Alipay1/HPM6P41_BB/README.md

# HPM6P41四开关电源开发板

目前项目处于暂停状态，作者正在考研，非常抱歉！
您可以拉取项目的Rev3最终版本提交，这个版本可以通过测试用例，能够基本满足开发板的运行要求（ADC部分有噪声）
Rev4将在项目恢复更新后继续完善

# 测试用例

测试用例尚未完全整理，但已经可以运行

需要使用sdk_gui工具选择board与app生成您的测试用例SES工程
