Alipay1/HPM6P41_BB/SoftwareExamples/core_voltage/at24cxx/interface/driver_at24cxx_interface_template.c

/**
 * Copyright (c) 2015 - present LibDriver All rights reserved
 *
 * The MIT License (MIT)
 *
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
 * @file      driver_at24cxx_interface_template.c
 * @brief     driver at24cxx interface template source file
 * @version   2.0.0
 * @author    Shifeng Li
 * @date      2021-02-17
 *
 * <h3>history</h3>
 * <table>
 * <tr><th>Date        <th>Version  <th>Author      <th>Description
 * <tr><td>2021/02/17  <td>2.0      <td>Shifeng Li  <td>format the code
 * <tr><td>2020/10/15  <td>1.0      <td>Shifeng Li  <td>first upload
 * </table>
 */

#include "driver_at24cxx_interface.h"

#include "SEGGER_RTT.h"
#include <stdarg.h>

#include "board.h"
#include "board_i2c.h"

#include "hpm_i2c.h"

/**
 * @brief  interface iic bus init
 * @return status code
 *         - 0 success
 *         - 1 iic init failed
 * @note   none
 */
uint8_t at24cxx_interface_iic_init(void) {
    return 0;
}

/**
 * @brief  interface iic bus deinit
 * @return status code
 *         - 0 success
 *         - 1 iic deinit failed
 * @note   none
 */
uint8_t at24cxx_interface_iic_deinit(void) {
  return 0;
}

/**
 * @brief      interface iic bus read
 * @param[in]  addr iic device write address
 * @param[in]  reg iic register address
 * @param[out] *buf pointer to a data buffer
 * @param[in]  len length of the data buffer
 * @return     status code
 *             - 0 success
 *             - 1 read failed
 * @note       none
 */
uint8_t at24cxx_interface_iic_read(uint8_t addr, uint8_t reg, uint8_t *buf, uint16_t len) {
  return hpm_i2c_master_addr_read_blocking(board_get_i2c_context(), addr>>1, reg, 1, buf, len, 0xFF);
}

/**
 * @brief     interface iic bus write
 * @param[in] addr iic device write address
 * @param[in] reg iic register address
 * @param[in] *buf pointer to a data buffer
 * @param[in] len length of the data buffer
 * @return    status code
 *            - 0 success
 *            - 1 write failed
 * @note      none
 */
uint8_t at24cxx_interface_iic_write(uint8_t addr, uint8_t reg, uint8_t *buf, uint16_t len) {
  return hpm_i2c_master_addr_write_blocking(board_get_i2c_context(), addr>>1, reg, 1, buf, len, 0xFFFF);
}

/**
 * @brief      interface iic bus read with 16 bits register address
 * @param[in]  addr iic device write address
 * @param[in]  reg iic register address
 * @param[out] *buf pointer to a data buffer
 * @param[in]  len length of the data buffer
 * @return     status code
 *             - 0 success
 *             - 1 read failed
 * @note       none
 */
uint8_t at24cxx_interface_iic_read_address16(uint8_t addr, uint16_t reg, uint8_t *buf, uint16_t len) {
  return hpm_i2c_master_addr_read_blocking(board_get_i2c_context(), addr>>1, reg, 2, buf, len, 0xFF);
}

/**
 * @brief     interface iic bus write with 16 bits register address
 * @param[in] addr iic device write address
 * @param[in] reg iic register address
 * @param[in] *buf pointer to a data buffer
 * @param[in] len length of the data buffer
 * @return    status code
 *            - 0 success
 *            - 1 write failed
 * @note      none
 */
uint8_t at24cxx_interface_iic_write_address16(uint8_t addr, uint16_t reg, uint8_t *buf, uint16_t len) {
  return hpm_i2c_master_addr_write_blocking(board_get_i2c_context(), addr>>1, reg, 2, buf, len, 0xFF);
}

/**
 * @brief     interface delay ms
 * @param[in] ms time
 * @note      none
 */
void at24cxx_interface_delay_ms(uint32_t ms) {
  board_delay_ms(ms);
}

/**
 * @brief     interface print format data
 * @param[in] fmt format data
 * @note      none
 */

// void at24cxx_interface_debug_print(const char *const fmt, ...) {
//   char buf[128];
//   va_list args;
//   va_start(args, fmt);
//   int len = vsnprintf(buf, sizeof(buf), fmt, args);
//   va_end(args);
// }
