Alipay1/HPM6P41_BB/(commit log)

2025-05-19 首次提交，第一次打样的版本
    [BB.kicad_sch, HPM6P41_BB.kicad_pcb, HPM6P41_BB.kicad_sch, MCU_IO_A.kicad_sch, MCU_IO_B_C.kicad_sch, MCU_IO_D.kicad_sch, MCU_MISC.kicad_sch, MCU_MISC2.kicad_sch]
2025-05-19 添加README
2025-05-22 修复VDD_SOC的SNS未连接的错误
    [HPM6P41_BB.kicad_pcb, MCU_PWR.kicad_sch]
2025-05-22 更改所有封装为SOD-323的1N4148W为1N4148WS 添加分压器的钳位二极管
    [BB.kicad_sch, HPM6P41_BB.kicad_pcb, SENSE.kicad_sch]
2025-05-22 放置钳位二极管 修复分压器未接地
    [HPM6P41_BB.kicad_pcb]
2025-05-22 交换LED与按键位置，优化布线，调整位号丝印
    [HPM6P41_BB.kicad_pcb]
2025-05-22 添加JTAG接口的ESD保护
    [HPM6P41_BB.kicad_pcb, MCU_IO_A.kicad_sch, MCU_MISC.kicad_sch]
2025-05-22 添加蜂鸣器IO及走线，更改PINMUX配图
    [HPM6P41_BB.kicad_pcb, HPM6P41_BB.kicad_sch, MCU_MISC2.kicad_sch]
2025-05-22 修改丝印大小，位置
    [HPM6P41_BB.kicad_pcb, HPM6P41_BB.kicad_sch]
2025-05-23 Create main.yml
    AI生成的，我也不懂了
2025-05-23 删除main.yml，没用了
2025-05-23 放进Hardware目录
    [BB.kicad_sch, HPM6P41_BB.kicad_pcb, HPM6P41_BB.kicad_sch, MCU_IO_A.kicad_sch, MCU_IO_B_C.kicad_sch, MCU_IO_D.kicad_sch, MCU_MISC.kicad_sch, MCU_MISC2.kicad_sch]
2025-05-23 尝试修复上传为空的问题
2025-05-23 添加actions文件
2025-06-14 修改了UCC27211A封装，此芯片此前的封装均错误 修改了采样线布局，为SAR ADC加入前置RC
    [BB.kicad_sch, HPM6P41_BB.kicad_pcb, HPM6P41_BB.kicad_sch, MCU_MISC2.kicad_sch, MCU_PWR.kicad_sch, POWER.kicad_sch, SENSE.kicad_sch]
2025-06-14 换掉UCC27519，它居然要55%VDD才到逻辑高，换成UCC2751
    [BB.kicad_sch, HPM6P41_BB.kicad_pcb, HPM6P41_BB.kicad_sch, POWER.kicad_sch]
2025-06-18 Rev3最终版本
    [BB.kicad_sch, MCU_MISC.kicad_sch, SENSE.kicad_sch]
2025-06-18 修改PCB文件发布日期和REV信息
2025-07-03 外置核心电压SYR838以改善ADC噪声
    [HPM6P41_BB.kicad_sch, MCU_MISC.kicad_sch, MCU_MISC2.kicad_sch, MCU_PWR.kicad_sch, POWER.kicad_sch]
2025-07-04 换其他电感之前暂存一下
    [BB.kicad_sch, HPM6P41_BB.kicad_sch, MCU_IO_A.kicad_sch, MCU_MISC.kicad_sch, MCU_MISC2.kicad_sch, POWER.kicad_sch, SENSE.kicad_sch]
2025-07-10 完成Rev4 电源 驱动 模拟 IO
    [BB.kicad_sch, HPM6P41_BB.kicad_pcb, HPM6P41_BB.kicad_sch, MCU_IO_A.kicad_sch, MCU_MISC.kicad_sch, MCU_MISC2.kicad_sch, POWER.kicad_sch, SENSE.kicad_sch]
2025-08-18 更新readme暂停通知，添加测试用例源代码
    [HPM6P41_BB.kicad_pcb, MCU_MISC.kicad_sch, MCU_MISC2.kicad_sch]
2026-01-24 rev4修改核心供电前保存（当前SYR838）
    [BB.kicad_sch, HPM6P41_BB.kicad_pcb, HPM6P41_BB.kicad_sch, MCU_IO_A.kicad_sch, MCU_IO_B_C.kicad_sch, MCU_IO_D.kicad_sch, MCU_MISC.kicad_sch, MCU_MISC2.kicad_sch]
2026-01-24 修改spi_lcd例程，适应新版sdk提供的 SDK_VERSION_STRING，其他例程暂未修改
2026-01-27 小改丝印
    [HPM6P41_BB.kicad_pcb]
2026-01-27 详细注释 相移例程 的 计算单元配置过程
2026-01-28 能够自由控制频率占空比相位，但是发现死区问题，下一版需要脱离硬件死区，使用比较值实现死区，避免Q1 Q4成组时脉宽不一致
2026-01-31 外置核心电压作为新的board，修改部分sdk_version_string，i2c components不能再board的cmake里选用，待解决
2026-01-31 修改can例程和文字部分，外部回环即使关闭phy仍通过，搁置
2026-01-31 修复：严重BUG！隔离器485与CAN信号完全相反！
    [MCU_MISC.kicad_sch]
2026-02-01 修改以适应rev4的硬件
2026-02-01 修改例程适应新版sdk与rev4硬件
2026-02-20 Rev4保存
    [HPM6P41_BB.kicad_pcb, MCU_MISC2.kicad_sch, POWER.kicad_sch]
2026-06-05 Fix FSBB bridge arm mapping
2026-06-05 Poll ADC DMA for FSBB control
2026-06-06 Set FSBB PWM to 50 kHz
2026-06-06 Park boost leg for sync buck mode
2026-06-06 Tune sync buck loop response
2026-06-06 Keep buck control independent of VOFA
2026-06-06 Drive buck loop from divided ADC IRQ
2026-06-06 Route ADC trigger to active buck TRGO
2026-06-06 Save tested buck debug state
